ecamueira/tdse-tf_2-3/README.md

 

# **Sistema Automático de Gestión de Cultivos (SAGC)**

**Autores: Camueira Elias; Cascia Serena; Donadello Nicolas**

**Padrón: 110772; 107946; 112007**

**Fecha: 2do cuatrimestre 2025**

**Fecha de entrega estimada: 18/02/2026**

### **1\. Selección del proyecto a implementar**

#### **1.1 Objetivo del proyecto y resultados esperados**

El objetivo de este proyecto es desarrollar un sistema automatizado de cultivo que permita medir, registrar y controlar variables ambientales críticas (temperatura, humedad, riego, fertilización) e implementar iluminación espectral controlada (incluyendo rojo, azul y UV-A) para favorecer el desarrollo óptimo de los cultivos en sus distintas etapas. Además, a través de una aplicación móvil, el usuario puede cargar datos sobre el progreso del cultivo y ajustar parámetros. El sistema utiliza esta información para refinar su respuesta y optimizar el control de acuerdo con las necesidades específicas del cultivo.

#### **1.2 Proyectos similares**

En base al objetivo se proponen posibles proyectos que requieren el uso de hardware específico y se ponderan los aspectos a tener en cuenta para seleccionar el más adecuado.

1. **Base:** Control con monitoreo de humedad del suelo y temperatura y humedad del aire con irrigación de agua y fertilizantes e iluminación personalizada.
2. **Base + caudalimetro:** Control con monitoreo de humedad del suelo y temperatura y humedad del aire con irrigación (finamente monitoreada a través de un caudalímetro) de agua y fertilizantes e iluminación personalizada.
3. **Base + medidor de pH:** Control con monitoreo de humedad del suelo, temperatura y humedad del aire y calidad de los suelos (Índice de pH) con irrigación de agua y fertilizantes e iluminación personalizada.

Para comparar estas alternativas, se tienen en cuenta seis aspectos característicos, los cuales se ponderan del 1 al 10:
1.  **Disponibilidad del hardware (9):** Se evalúa si el proyecto puede implementarse utilizando hardware que se consiga fácilmente en el mercado regional, sin necesidad de importación o tiempos de envío extensos.
2.  **Impacto en el proyecto (8):** Se pondera cuánto aporta a la funcionalidad y control del crecimiento del cultivo.
3.  **Costo (8):** Se evalúa el costo total del hardware requerido para cada opción.
4.  **Dificultad técnica / Viabilidad (10):** Se contempla el tiempo requerido y la complejidad de implementación, teniendo en cuenta los conocimientos disponibles.
5.  **Interés personal del equipo (7):** Se pondera la motivación e interés del equipo en implementar cada alternativa.

La siguiente tabla (Tabla 1.2.1) muestra los valores ponderados asignados a cada proyecto considerado

<table>
    <thead>
        <tr>
            <th rowspan="2">Criterio</th>
            <th colspan="2">Proyecto Base</th>
            <th colspan="2">Base + Caudalímetro</th>
            <th colspan="2">Base + Medidor de pH</th>
        </tr>
        <tr>
            <th>Puntaje</th>
            <th>Puntaje Ponderado</th>
            <th>Puntaje</th>
            <th>Puntaje Ponderado</th>
            <th>Puntaje</th>
            <th>Puntaje Ponderado</th>
        </tr>
    </thead>
    <tbody>
        <tr class="header-row">
            <td align="center">Disponibilidad de Hardware <br>(peso: 9)</td>
            <td>10</td>
            <td>90</td>
            <td>10</td>
            <td>90</td>
            <td>4</td>
            <td>36</td>
        </tr>
        <tr>
            <td align="center">Impacto en el proyecto <br>(peso: 8)</td>
            <td>8</td>
            <td>64</td>
            <td>5</td>
            <td>40</td>
            <td>9</td>
            <td>72</td>
        </tr>
        <tr class="header-row">
            <td align="center">Costo (peso: 8)</td>
            <td>8</td>
            <td>64</td>
            <td>7</td>
            <td>56</td>
            <td>3</td>
            <td>24</td>
        </tr>
        <tr>
            <td align="center">Dificultad técnica / Viabilidad <br>(peso: 10)</td>
            <td>9</td>
            <td>90</td>
            <td>7</td>
            <td>70</td>
            <td>3</td>
            <td>30</td>
        </tr>
        <tr class="header-row">
            <td align="center">Interés personal <br>(peso: 7)</td>
            <td>8</td>
            <td>56</td>
            <td>8</td>
            <td>56</td>
            <td>9</td>
            <td>63</td>
        </tr>
        <tr class="highlight-green">
            <td><strong>Puntaje Total</strong></td>
            <td>-</td>
            <td><strong>364</strong></td>
            <td>-</td>
            <td>312</td>
            <td>-</td>
            <td class="highlight-red">225</td>
        </tr>
    </tbody>
</table>
<p align="center"><em>Tabla 1: Comparación de alternativas de proyecto</em></p>

#### **1.3 Selección de proyecto**

Vistas las consideraciones tomadas en cuenta para discriminar cuál sería el proyecto óptimo para desarrollar, se decidió seguir adelante con la opción Base. Esta, a contraposición de las otras, cumple con lo mínimo que se pretende manteniendo a su vez un costo racional respecto a lo que ofrece. Si bien tanto el módulo de control de caudal como el de control de pH ofrecen nueva información más exacta, esta no tiene un impacto que justifique un poco el nivel de inversión que presupone.

De esta forma, el proyecto a desarrollar consiste en un sistema de control de crecimiento de varios tipos de plantas centrándose en el monitoreo de humedad del suelo y temperatura y humedad del aire y actuando mediante doble irrigación (nutrientes y agua), control de distintos espectros de luz y flujo de aire con un ventilador. Todo esto va a funcionar a la par de una configuración amplia y activa llevada a cabo de forma manual (usuario) como automática (mediante aprendizaje del sistema).

Los principales desafíos que se van a afrontar son la integración efectiva de los distintos sistemas, la sincronización a través de la APP y lograr una automatización efectiva a partir de la información “aprendida” por el sistema.

###### **1.3.1 Diagrama en bloques**

En la Figura 1 se muestra el diagrama en bloques del sistema con los principales módulos del proyecto

<p align="center">
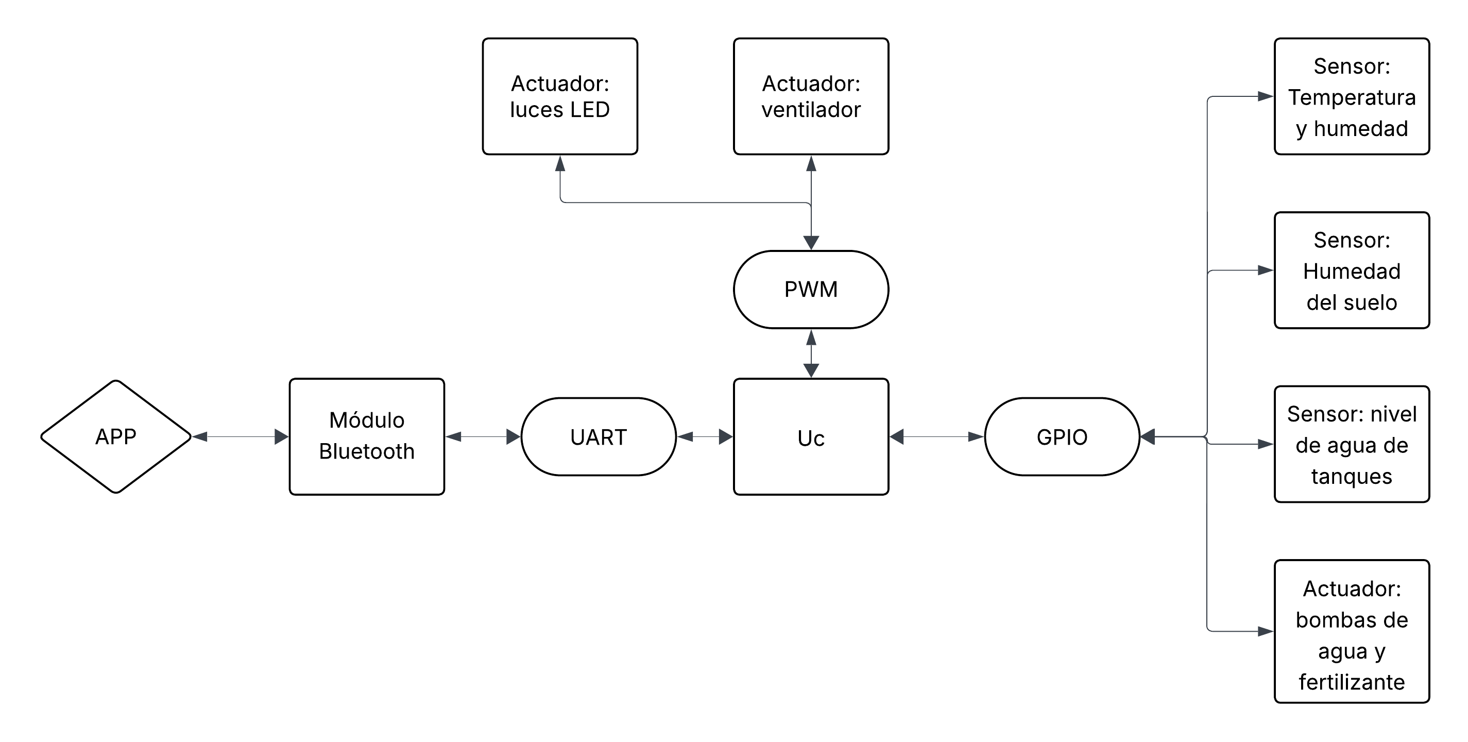
[picture p1: diagrama_en_bloques.png]
  
</p>

<p align="center"><em>Figura 1: Diagrama en bloques del sistema</em></p>

### **2\. Elicitación de requisitos y casos de uso**

En Argentina existen diversos productos orientados al monitoreo y control ambiental para cultivos indoor e invernaderos. Sin embargo, la mayoría de las soluciones disponibles se limita a funciones específicas (como riego, humedad o temporizadores) y no integran en un mismo sistema la totalidad de sensores, actuadores y conectividad inalámbrica que propone este proyecto.

Como primer competidor puede mencionarse a **Wentux (Argentina)**, empresa dedicada al desarrollo de automatización para cultivos indoor. Ofrece controladores de clima, módulos para extracción, temporizadores y dispositivos de riego. Si bien sus productos cubren funciones clave como temperatura y humedad, no incluyen controladores de fertilizacion, monitoreo de nivel de agua ni conectividad vía Wi-Fi o BLE con una app. Su enfoque está más orientado al control puntual de variables, no a un sistema integral. Ademas que sus productos y servicios son muy costosos, comparandolo con el que se propone implementar.

Un segundo competidor es **Autoplants Argentina**, que fabrica sistemas automáticos de riego y control básico de humedad para cultivos en interior y exterior. Estos dispositivos permiten controlar el riego y medir humedad ambiente, pero carecen de un sistema unificado que combine ventilación, luz artificial, sensado de varias variables y configuración remota mediante WIFI o BLE. Tampoco integran sensores específicos como nivel de agua.

En conclusión, si bien Argentina cuenta con empresas que producen controladores ambientales y sistemas automáticos para cultivos indoor o invernaderos, ninguna ofrece una solución completa que combine: sensores de humedad de suelo, temperatura, humedad ambiente, nivel de agua, control de ventilación, luz artificial y conectividad Wi-Fi/BLE integrada en un único dispositivo. Esto posiciona al proyecto como una propuesta innovadora, accesible y adaptada a un segmento del mercado que actualmente no está cubierto con una solución integral. Ademas, al implementarlo con componentes y modulos que pueden conseguirse en el mercado local, el proyecto disminuye significativamente tiempos y costos de desarrollo. Ademas, esto nos permite reemplazos rápidos, disponibilidad inmediata de repuestos y una mayor viabilidad para producir o escalar el sistema sin depender de importaciones o proveedores externos.

| Grupo | ID | Descripción |
| :---- | :---- | :---- |
| Sensores ambientales | 1.1 | El sistema contará con un sensor de temperatura y humedad ambiente (DHT22) para supervisar condiciones del cultivo. |
|  | 1.2 | El sistema contará con un sensor de humedad de suelo (preferentemente capacitivo) por maceta/zona para gobernar el riego automático. |
|  | 1.3 | El sistema realizará lecturas periódicas de los sensores a una frecuencia configurable y enviará valores a la app. |
| Actuadores — Riego | 2.1 | El sistema controlará una bomba para activar riego en función del umbral de humedad de suelo configurado. |
|  | 2.2 | El sistema controlará una bomba para activar la fertilización líquida en función del tiempo o de la cantidad de riegos de agua efectuados, lo que ocurra primero.|
|  | 2.3 | El riego será interrumpido automáticamente si se detecta falta de agua (sensor de nivel de tanque) o marcha en seco (protección). |
| Actuadores — Iluminación | 2.4 | El sistema contará con una tira LED RGB (analógica o direccionable) para iluminación artificial del cultivo, controlada por PWM. |
|  | 2.5 | La intensidad y el espectro (combinación R/G/B) serán configurables desde la aplicación para definir fotoperíodos y etapas (crecimiento / fructificación). |
| Actuadores — Ventilación | 2.6 | El sistema contará con un ventilador tipo PC (cooler) controlable por PWM y por MOSFET de ser necesario, para renovación de aire y control térmico local. |
|  | 2.7 | El ventilador podrá operar en modos definidos por firmware (p. ej. ON/OFF, control proporcional por temperatura/humedad), seleccionables desde la app. |
|  | 2.8 | Si se desea, el sistema leerá la señal tach del ventilador para medir RPM y validar que el ventilador está funcionando. |
| Almacenamiento | 3.1 | La configuración del sistema (umbrales, fotoperíodos, parámetros) se persistirá en la **Flash interna** del microcontrolador. |
|  | 3.2 | El sistema recuperará la configuración guardada al iniciar y validará la integridad de la misma. |
| Interfaz/App | 4.1 | Toda la interacción de usuario, notificaciones y alarmas se realizará mediante la aplicación móvil conectada por BLE. |
|  | 4.2 | La app permitirá configurar umbrales, iniciar riegos manuales, programar fotoperíodos y controlar el ventilador. |
|  | 4.3 | El sistema enviará a la app lecturas periódicas y eventos críticos (ej. falta de agua, sensor desconectado, fallo de ventilador). |
| Operación segura | 5.1 | Si ocurre un evento inesperado que suponga un riesgo al sistema, el mismo deberá reiniciar con los actuadores en estado pasivo |

<p align="center"><em>Tabla 2: Requisitos del proyecto</em></p>

En las tablas 3.1 a 3.3 se presentan 3 casos de uso para el sistema.

| Elemento | Definición |
| :---- | :---- |
| **Disparador** | El sistema detecta que la humedad del suelo cae por debajo del umbral configurado. | 
| **Precondiciones** | El sistema está encendido. La bomba está conectada y con agua disponible. La humedad objetivo está configurada en la app y almacenada en Flash. El sensor de humedad de suelo está funcionando.| 
| **Flujo principal** | El sistema realiza una lectura periódica del sensor de humedad de suelo. Si la lectura está por debajo del umbral, enciende la bomba mediante MOSFET e inicia el riego automático. El sistema notifica a la app que se realizó un riego automático. |
| **Flujos alternativos** | a. El tanque no tiene agua: el sensor de nivel indica vacío y el riego no se ejecuta; se envía alerta a la app. | 

<p align="center"><em>Tabla 3.1: Caso de uso 1: Riego automático</em></p>

| Elemento | Definición |
| :---- | :---- |
| **Disparador** | La app envía una configuración de color, intensidad o fotoperíodo para la tira LED.| 
| **Precondiciones** | El sistema está encendido. La tira LED está conectada mediante PWM. La app está enlazada por BLE. Los parámetros previos están almacenados en Flash. | 
| **Flujo principal** | El usuario selecciona en la app el modo de iluminación deseado (manual o fotoperíodo). La app envía los parámetros de color e intensidad al microcontrolador. El firmware actualiza las señales PWM. La iluminación cambia inmediatamente y el sistema confirma la actualización a la app. |
| **Flujos alternativos** | a. Se pierde la conexión BLE: el sistema mantiene la configuración previa y notifica error. <br> b. La app envía valores fuera de rango: el firmware descarta el comando y envía error a la app. |

<p align="center"><em>Tabla 3.2: Caso de uso 2: Control de iluminación</em></p>

| Elemento | Definición |
| :---- | :---- |
| **Disparador** | La temperatura ambiente medida por el DHT22 supera el umbral configurado o el usuario activa el ventilador desde la app. | 
| **Precondiciones** | El sistema está encendido. El ventilador está conectado mediante MOSFET y PWM. El sensor DHT22 está operativo. Los umbrales están configurados y guardados en Flash. La app está enlazada por BLE si se utiliza el modo manual. | 
| **Flujo principal** | El sistema realiza una lectura de temperatura. Si supera el umbral definido, el firmware activa el ventilador y ajusta su velocidad mediante PWM según la temperatura. Si el usuario usa el modo manual, puede activar/desactivar el ventilador o ajustar la velocidad desde la app. El sistema envía a la app el estado del ventilador y las lecturas actuales. |
| **Flujos alternativos** | a. La temperatura vuelve a valores normales: el ventilador se apaga. <br> b. El ventilador falla o no gira (si se mide tac/RPM): el sistema notifica falla a la app. |

<p align="center"><em>Tabla 3.3: Caso de uso 3: Control del ventilador según temperatura</em></p>
