ecamueira/tdse-tf_2-3/tdse-tf_2-3.ioc

Mcu.UserName=STM32F103RBTx
PA0-WKUP.Signal=ADCx_IN0
PA1.Signal=ADCx_IN1
PA10.Signal=S_TIM1_CH3
PA13.GPIO_Label=TMS
PA13.Signal=SYS_JTMS-SWDIO
PA14.GPIO_Label=TCK
PA14.Signal=SYS_JTCK-SWCLK
PA15.Signal=S_TIM2_CH1_ETR
PA2.GPIO_Label=USART_TX
PA2.Signal=USART2_TX
PA3.GPIO_Label=USART_RX
PA3.Signal=USART2_RX
PA4.Signal=ADCx_IN4
PA5.GPIO_Label=LD2 [Green Led]
PA5.Signal=GPIO_Output
PA9.Signal=S_TIM1_CH2
PB0.Signal=GPIO_Output
PB10.Signal=I2C2_SCL
PB11.Signal=I2C2_SDA
PB3.GPIO_Label=SWO
PB3.Signal=SYS_JTDO-TRACESWO
PB6.Signal=S_TIM4_CH1
PB8.Signal=I2C1_SCL
PB9.Signal=I2C1_SDA
PC1.Signal=GPIO_Output
PC10.Signal=USART3_TX
PC11.Signal=USART3_RX
PC13-TAMPER-RTC.GPIO_Label=B1 [Blue PushButton]
PC13-TAMPER-RTC.Signal=GPXTI13
PC14-OSC32_IN.Signal=RCC_OSC32_IN
PC15-OSC32_OUT.Signal=RCC_OSC32_OUT
PD0-OSC_IN.Signal=RCC_OSC_IN
PD1-OSC_OUT.Signal=RCC_OSC_OUT
