ecamueira/tdse-tf_2-3/app/inc/task_sensor_BLE.h

#ifndef TASK_INC_TASK_SENSOR_BLE_H_
#define TASK_INC_TASK_SENSOR_BLE_H_

/********************** CPP guard ********************************************/
#ifdef __cplusplus
extern "C" {
#endif

/********************** inclusions *******************************************/

/********************** macros ***********************************************/

/********************** typedef **********************************************/

/********************** external data declaration ****************************/
extern uint32_t g_task_sensor_BLE_cnt;
extern volatile uint32_t g_task_sensor_BLE_tick_cnt;

/********************** external functions declaration ***********************/
extern void task_sensor_BLE_init(void *parameters);
extern void task_sensor_BLE_update(void *parameters);

/********************** End of CPP guard *************************************/
#ifdef __cplusplus
}
#endif

#endif /* TASK_INC_TASK_SENSOR_H_ */

/********************** end of file ******************************************/
