ecamueira/tdse-tf_2-3/app/inc/task_system_level_tanque_interface.h

#ifndef TASK_INC_TASK_SYSTEM_LEVEL_TANQUE_INTERFACE_H_
#define TASK_INC_TASK_SYSTEM_LEVEL_TANQUE_INTERFACE_H_

/********************** CPP guard ********************************************/
#ifdef __cplusplus
extern "C" {
#endif

/********************** inclusions *******************************************/

/********************** macros ***********************************************/

/********************** typedef **********************************************/

/********************** external data declaration ****************************/

/********************** external functions declaration ***********************/
extern void put_nivel_tanque_value(uint16_t valor, int index);
/********************** End of CPP guard *************************************/
#ifdef __cplusplus
}
#endif

#endif /* TASK_INC_TASK_SYSTEM_LEVEL_TANQUE_INTERFACE_H_ */

/********************** end of file ******************************************/
