ecamueira/tdse-tf_2-3/app/inc/task_system_riego.h

#ifndef TASK_INC_TASK_SYSTEM_RIEGO_H_
#define TASK_INC_TASK_SYSTEM_RIEGO_H_

/********************** CPP guard ********************************************/
#ifdef __cplusplus
extern "C" {
#endif

/********************** inclusions *******************************************/

/********************** macros ***********************************************/

/********************** typedef **********************************************/

/********************** external data declaration ****************************/
extern uint32_t g_task_system_riego_cnt;
extern volatile uint32_t g_task_system_riego_tick_cnt;

/********************** external functions declaration ***********************/
extern void task_system_riego_init(void *parameters);
extern void task_system_riego_update(void *parameters);

/********************** End of CPP guard *************************************/
#ifdef __cplusplus
}
#endif

#endif /* TASK_INC_TASK_SYSTEM_RIEGO_H_ */

/********************** end of file ******************************************/
