ecamueira/tdse-tf_2-3/app/src/task_system_riego_interface.c

/********************** inclusions *******************************************/
/* Project includes */
#include <task_system_riego_attribute.h>
#include "main.h"

/* Demo includes */
#include "logger.h"
#include "dwt.h"

/* Application & Tasks includes */
#include "board.h"
#include "app.h"

/********************** macros and definitions *******************************/

/********************** internal data declaration ****************************/

/********************** internal functions declaration ***********************/

/********************** internal data definition *****************************/

/********************** external data declaration ****************************/

/********************** external functions definition ************************/
void put_humedad_suelo_value_min(uint8_t valor) {
    task_system_riego_dta.humedad_suelo_min = valor;
}
void put_riego_humedad_ambiente_value_min(uint8_t valor) {
    task_system_riego_dta.humedad_ambiente_min = valor;
}
void put_riego_temperatura_ambiente_value_max(uint8_t valor) {
    task_system_riego_dta.temperatura_ambiente_max = valor;
}
void put_humedad_suelo_value(uint16_t valor) {
    task_system_riego_dta.humedad_suelo = valor;
}
void put_riego_humedad_temperatura_ambiente_value(float hum_amb, float temp_amb) {
    task_system_riego_dta.humedad_ambiente = hum_amb;
    task_system_riego_dta.temperatura = temp_amb;
}
void put_level_tanque_agua_value(bool flag_tanque) {
    task_system_riego_dta.flag_tanque=flag_tanque;
}
/********************** end of file ******************************************/
