ecamueira/tdse-tf_2-3/(commit log)

2025-12-05 Revision Readme
    Adjuntamos la propuesta inicial, incluyendo README y diagrama.
2026-02-06 informe de avance
2026-04-29 entrega final
    [tdse-tf_2-3 Debug.cfg, tdse-tp2_01-model_integration Debug.cfg, tdse-tp2_01-model_integration.cfg]
